dedmunds2/CHT-EGT-Aviation-Instrument-Arduino/Arduino thermcouple.brd

## EAGLE design Arduino thermcouple.brd (2015-07-14)

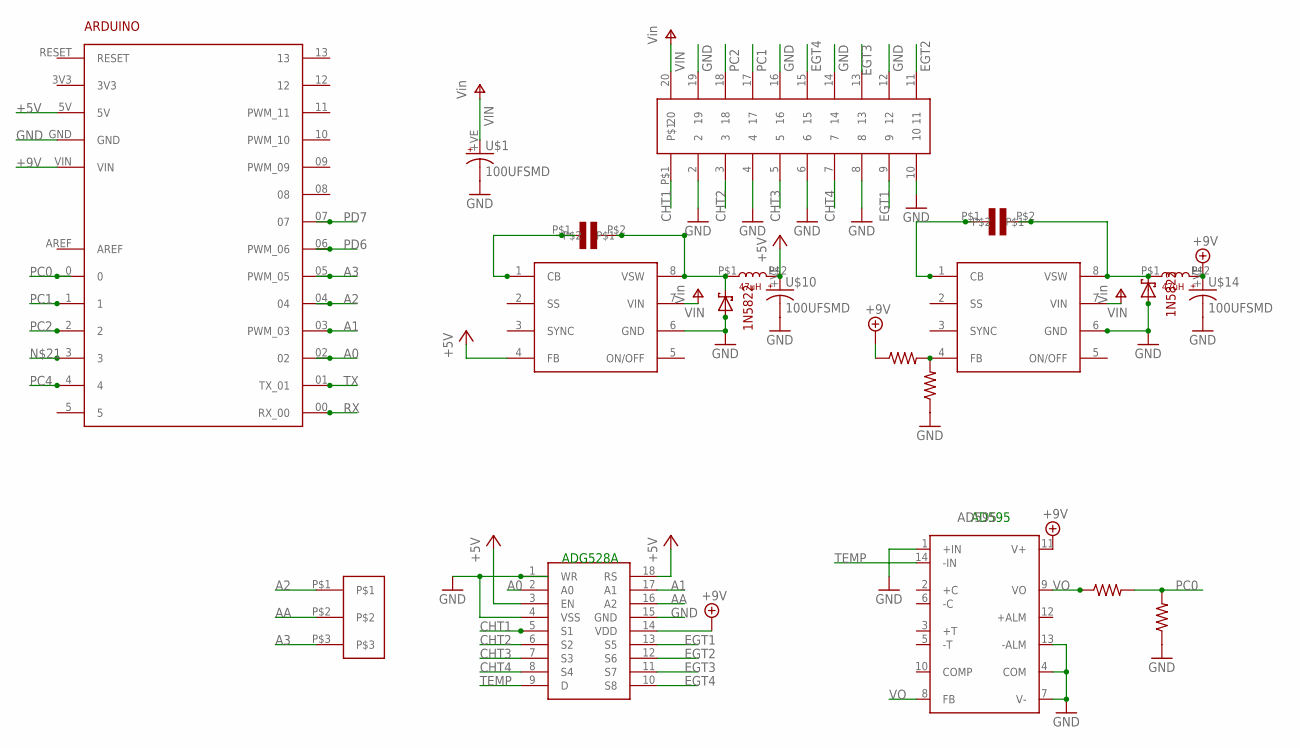
[picture p1: schematic Arduino thermcouple.sch]

Parts:
": ADG528A; DIL18
ARDUINO2: ARDUINO
IC2: AD595; DIL14
R5, R6: 10K; 0.3RESISTOR
U$1, U$10, U$14: 100UFSMD
U$2, U$4: 1N5822
U$3, U$6: LM2672; DIL08
U$5, U$7: 01CAP
U$8: 20PIN0.1INCH
U$9, U$13: 47uH; 47UHSMD
U$15: 1K5; 0.3RESISTOR
U$16: 10K; 0.3RESISTOR
U$17: 3PINHEADER

Connections:
+5V: ".3 (EN), ".18 (RS), ARDUINO2.5V, U$3.4 (FB), U$9.P$2 (2), U$10.+VE (+)
+9V: ".14 (VDD), ARDUINO2.VIN, IC2.11 (V+), U$13.P$2 (2), U$14.+VE (+), U$16.P$1 (1)
A0: ".2 (A0), ARDUINO2.02
A1: ".17 (A1), ARDUINO2.03 (PWM_03)
A2: ARDUINO2.04, U$17.P$1
A3: ARDUINO2.05 (PWM_05), U$17.P$3
AA: ".16 (A2), U$17.P$2
CHT1: ".5 (S1), U$8.P$1
CHT2: ".6 (S2), U$8.3
CHT3: ".7 (S3), U$8.5
CHT4: ".8 (S4), U$8.7
EGT1: ".13 (S5), U$8.9
EGT2: ".12 (S6), U$8.11
EGT3: ".11 (S7), U$8.13
EGT4: ".10 (S8), U$8.15
GND: ".1 (WR), ".4 (VSS), ".15 (GND), ARDUINO2.GND, IC2.1 (+IN), IC2.4 (COM), IC2.7 (V-), IC2.13 (-ALM), R6.P$1 (1), U$1.-VE (-), U$2.A, U$3.6 (GND), U$4.A, U$6.6 (GND), U$8.2, U$8.4, U$8.6, U$8.8, U$8.10, U$8.12, U$8.14, U$8.16, U$8.19, U$10.-VE (-), U$14.-VE (-), U$15.P$1 (1)
unnamed: U$6.1 (CB), U$7.P$1
unnamed: U$3.1 (CB), U$5.P$1
unnamed: U$2.K (C), U$3.8 (VSW), U$5.P$2, U$9.P$1 (1)
unnamed: U$6.4 (FB), U$15.P$2 (2), U$16.P$2 (2)
unnamed: U$4.K (C), U$6.8 (VSW), U$7.P$2, U$13.P$1 (1)
PC0: ARDUINO2.0, R5.P$2 (2), R6.P$2 (2)
PC1: ARDUINO2.1, U$8.17
PC2: ARDUINO2.2, U$8.18
PC4: ARDUINO2.4
PD6: ARDUINO2.06 (PWM_06)
PD7: ARDUINO2.07
RX: ARDUINO2.00 (RX_00)
TEMP: ".9 (D), IC2.14 (-IN)
TX: ARDUINO2.01 (TX_01)
VIN: U$1.+VE (+), U$3.7 (VIN), U$6.7 (VIN), U$8.20
VO: IC2.8 (FB), IC2.9 (VO), R5.P$1 (1)

Notes on the sheet:
ADG528A
AD595

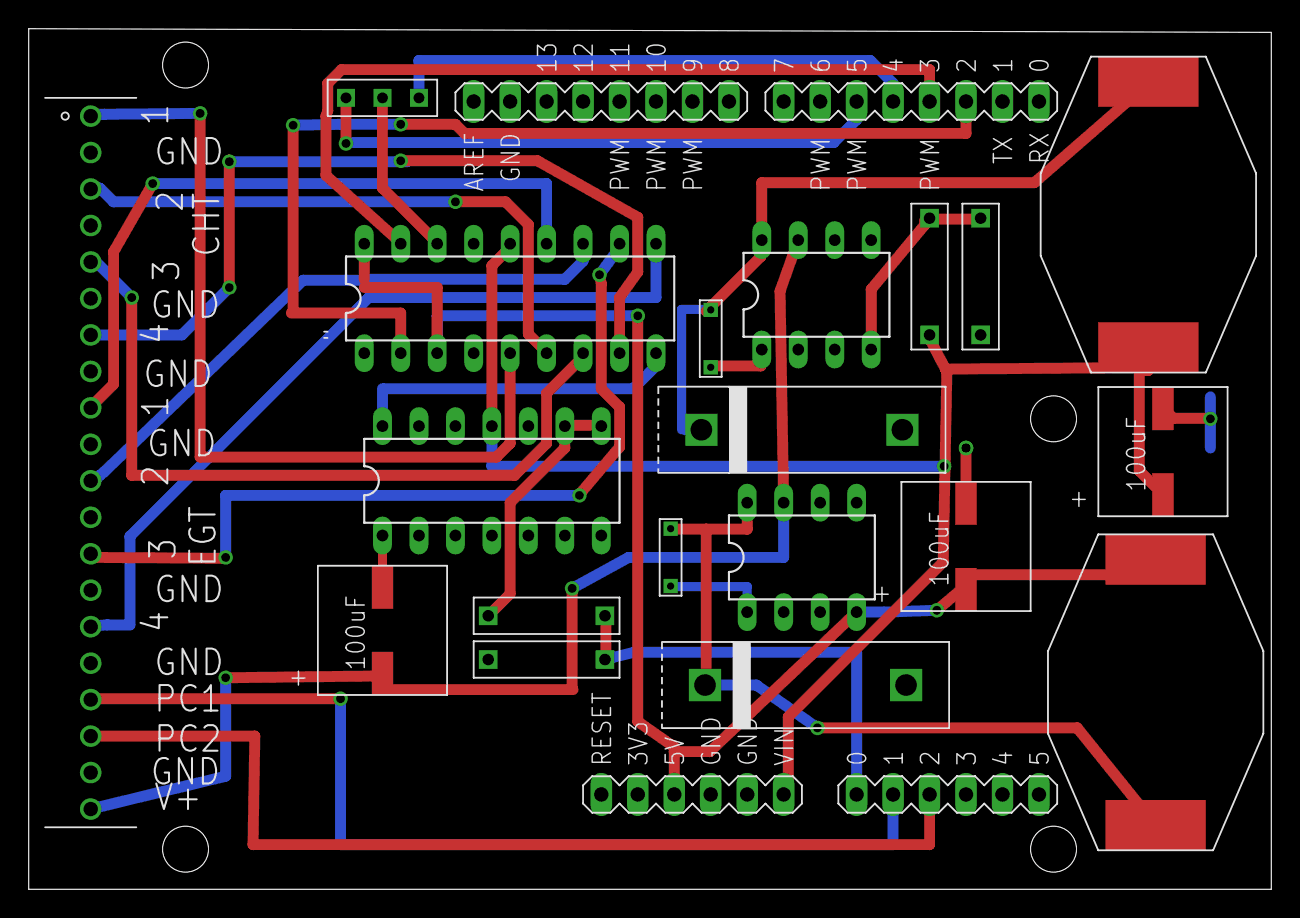
[picture p2: board Arduino thermcouple.brd from above]

Board: 2 copper layers, 86.5 x 59.9 mm, 20 parts (0 on the bottom side), 27 nets.
