dedmunds2/CHT-EGT-Aviation-Instrument-Arduino/(commit log)

2015-07-14 Eagle files added
    [Arduino thermcouple.brd, Arduino thermcouple.sch]
2015-09-01 fix to multiplexer address space
    [Engine_monitor_TFT.ino]
